TweetyDaBird/Lotus-58-BLE/v1.20/bom/README.md

# Interactive BOM
To view the interactive bom, use the html preview link here: http://htmlpreview.github.io/?https://github.com/TweetyDaBird/Lotus-58-BLE/blob/main/v1.20/bom/ibom.html
