TweetyDaBird/Lotus-58-BLE/Schematic.pdf

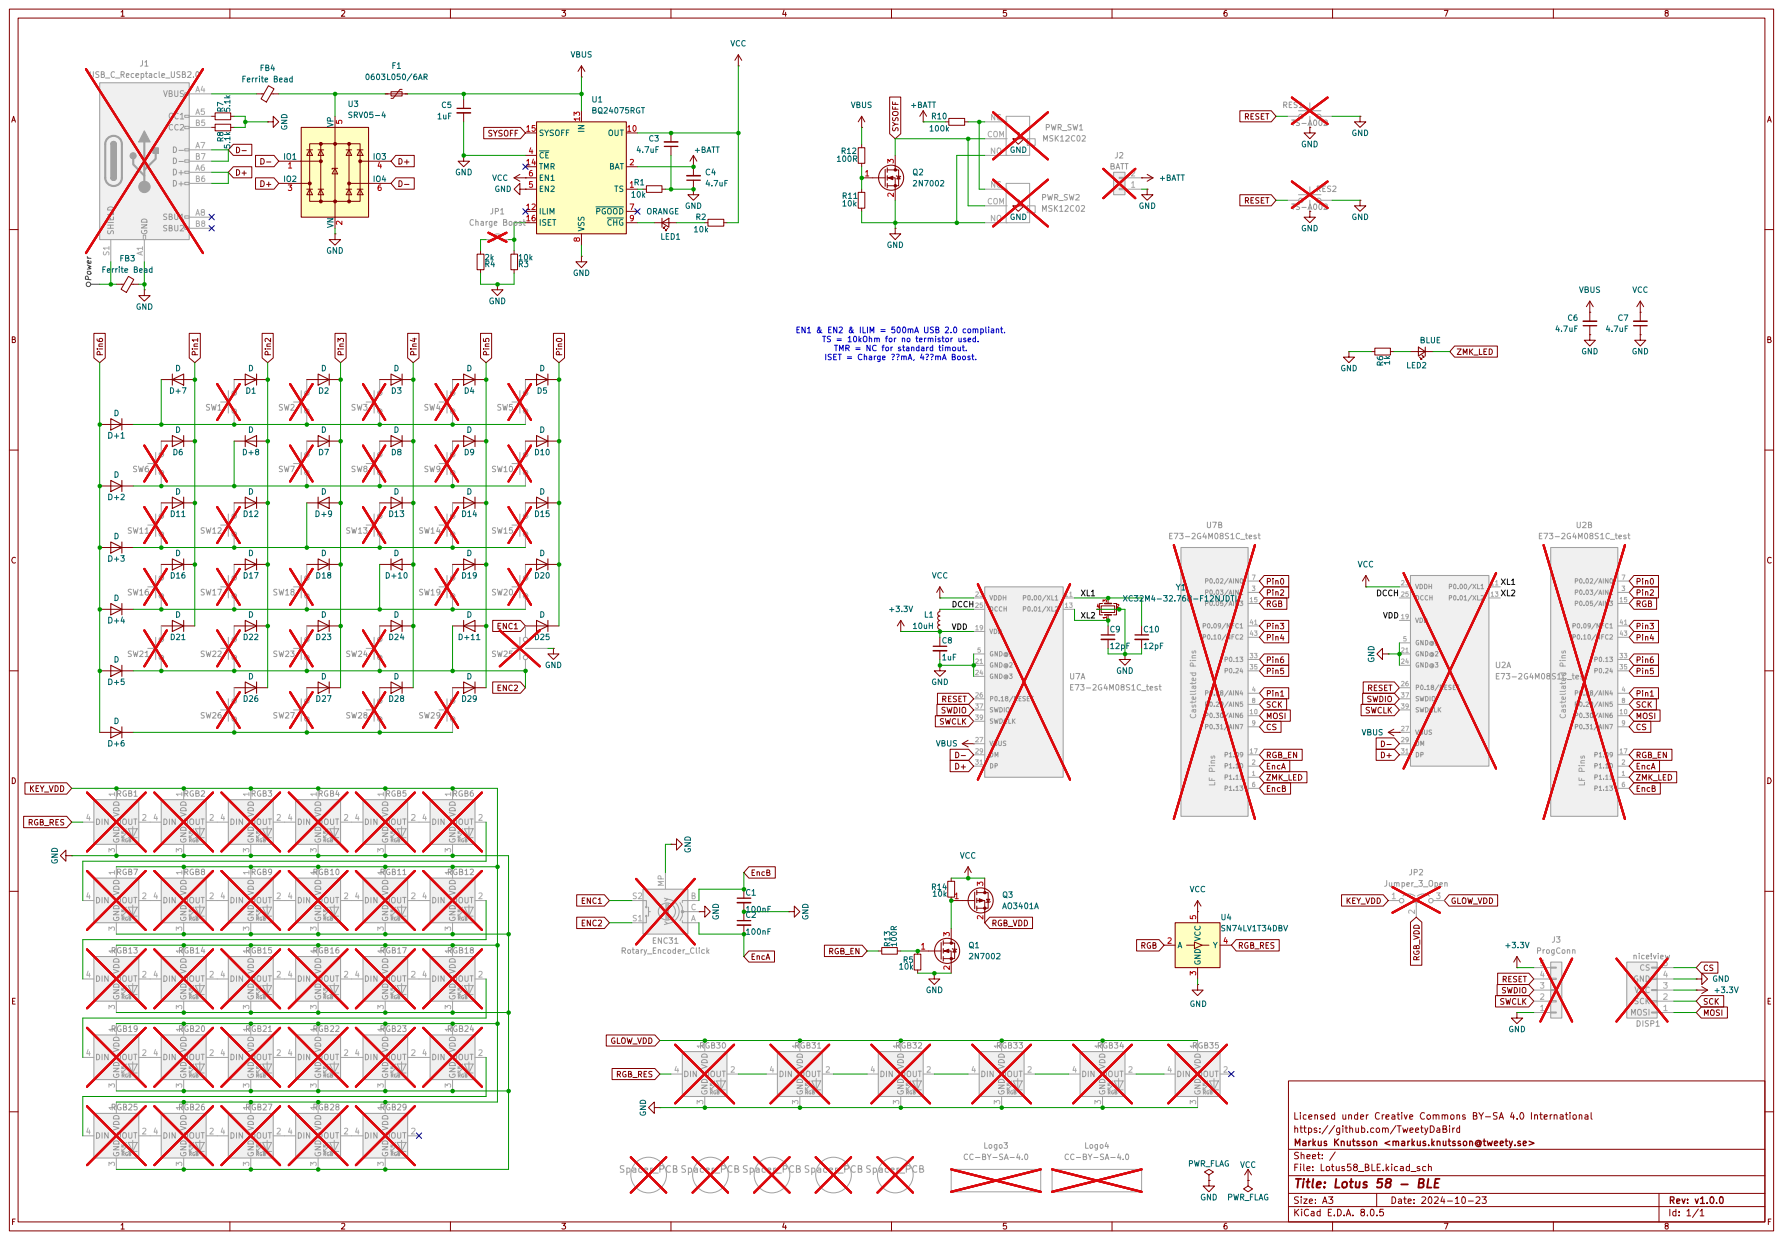
[picture p1: page 1]
