TweetyDaBird/Lotus-58-BLE/v1.20/Lotus58_BLE.kicad_pcb

## KiCad design v1.20/Lotus58_BLE.kicad_pcb (2025-06-25)

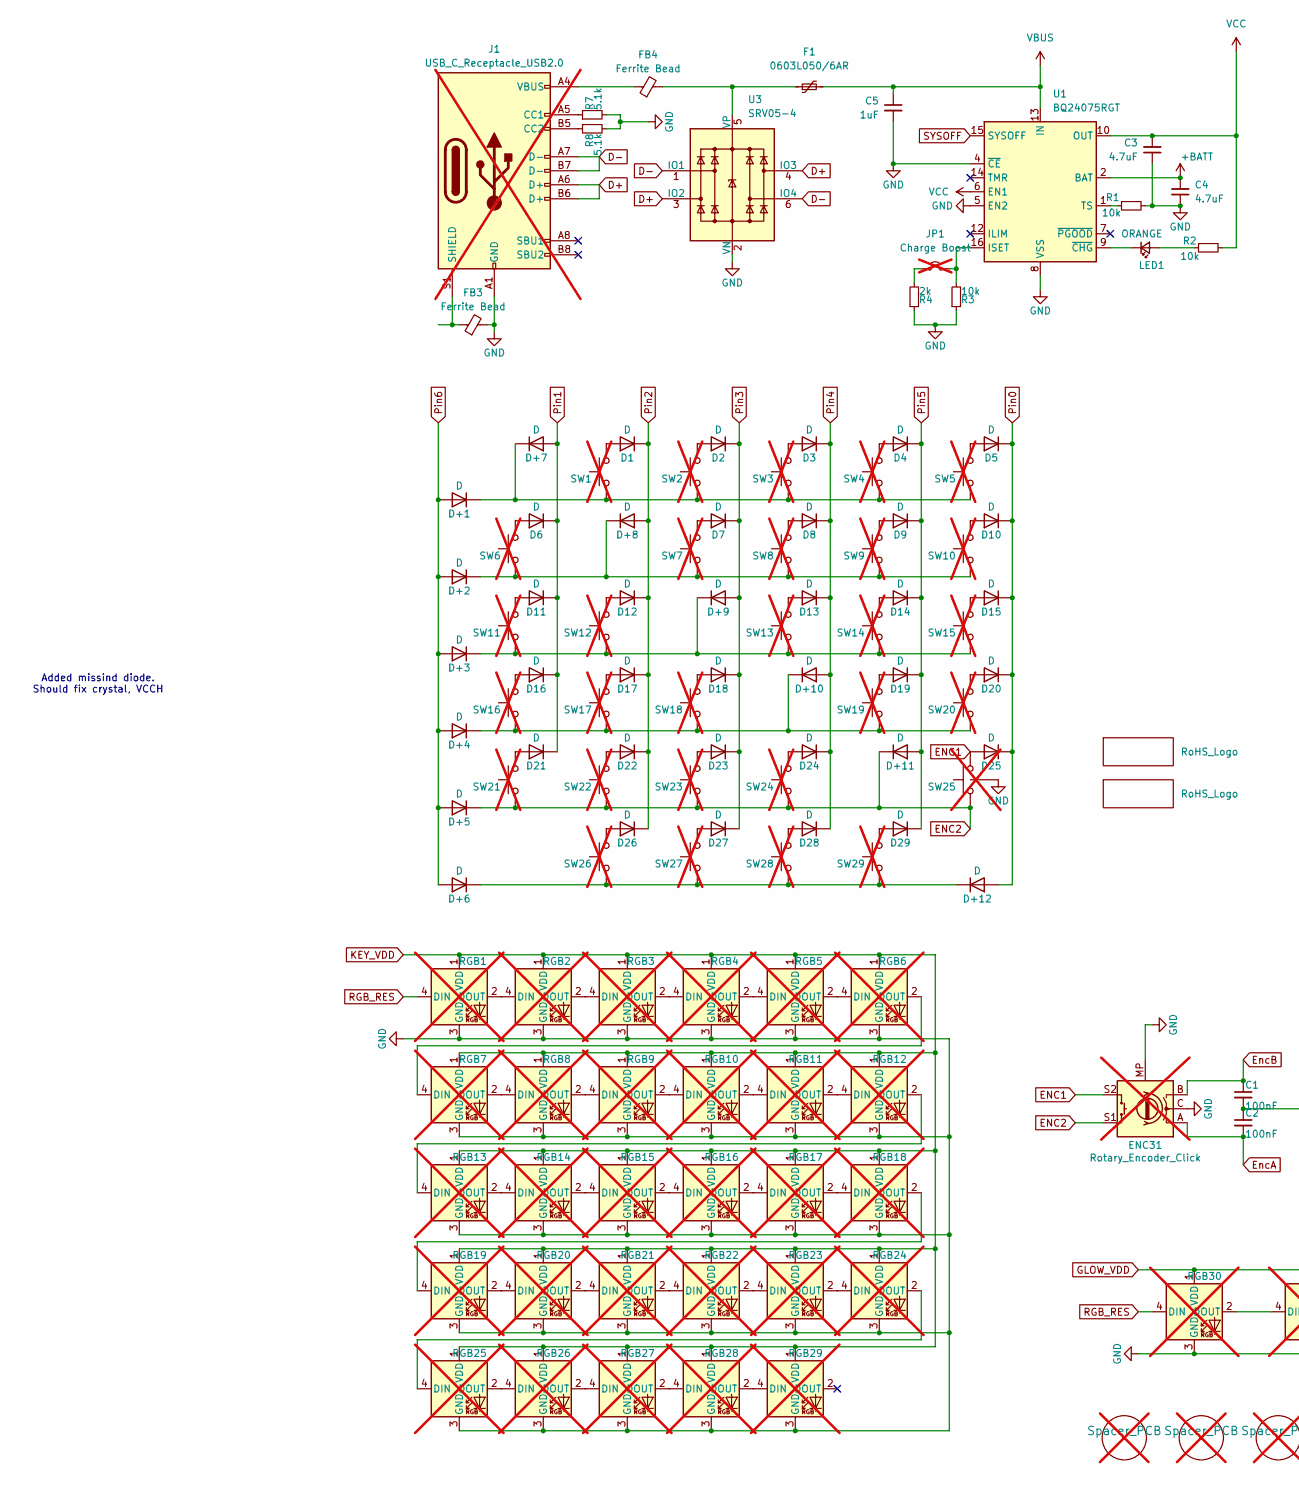
[picture p2: schematic Lotus58_BLE.kicad_sch, Lotus 58 - BLE, part in row 1, column 1]

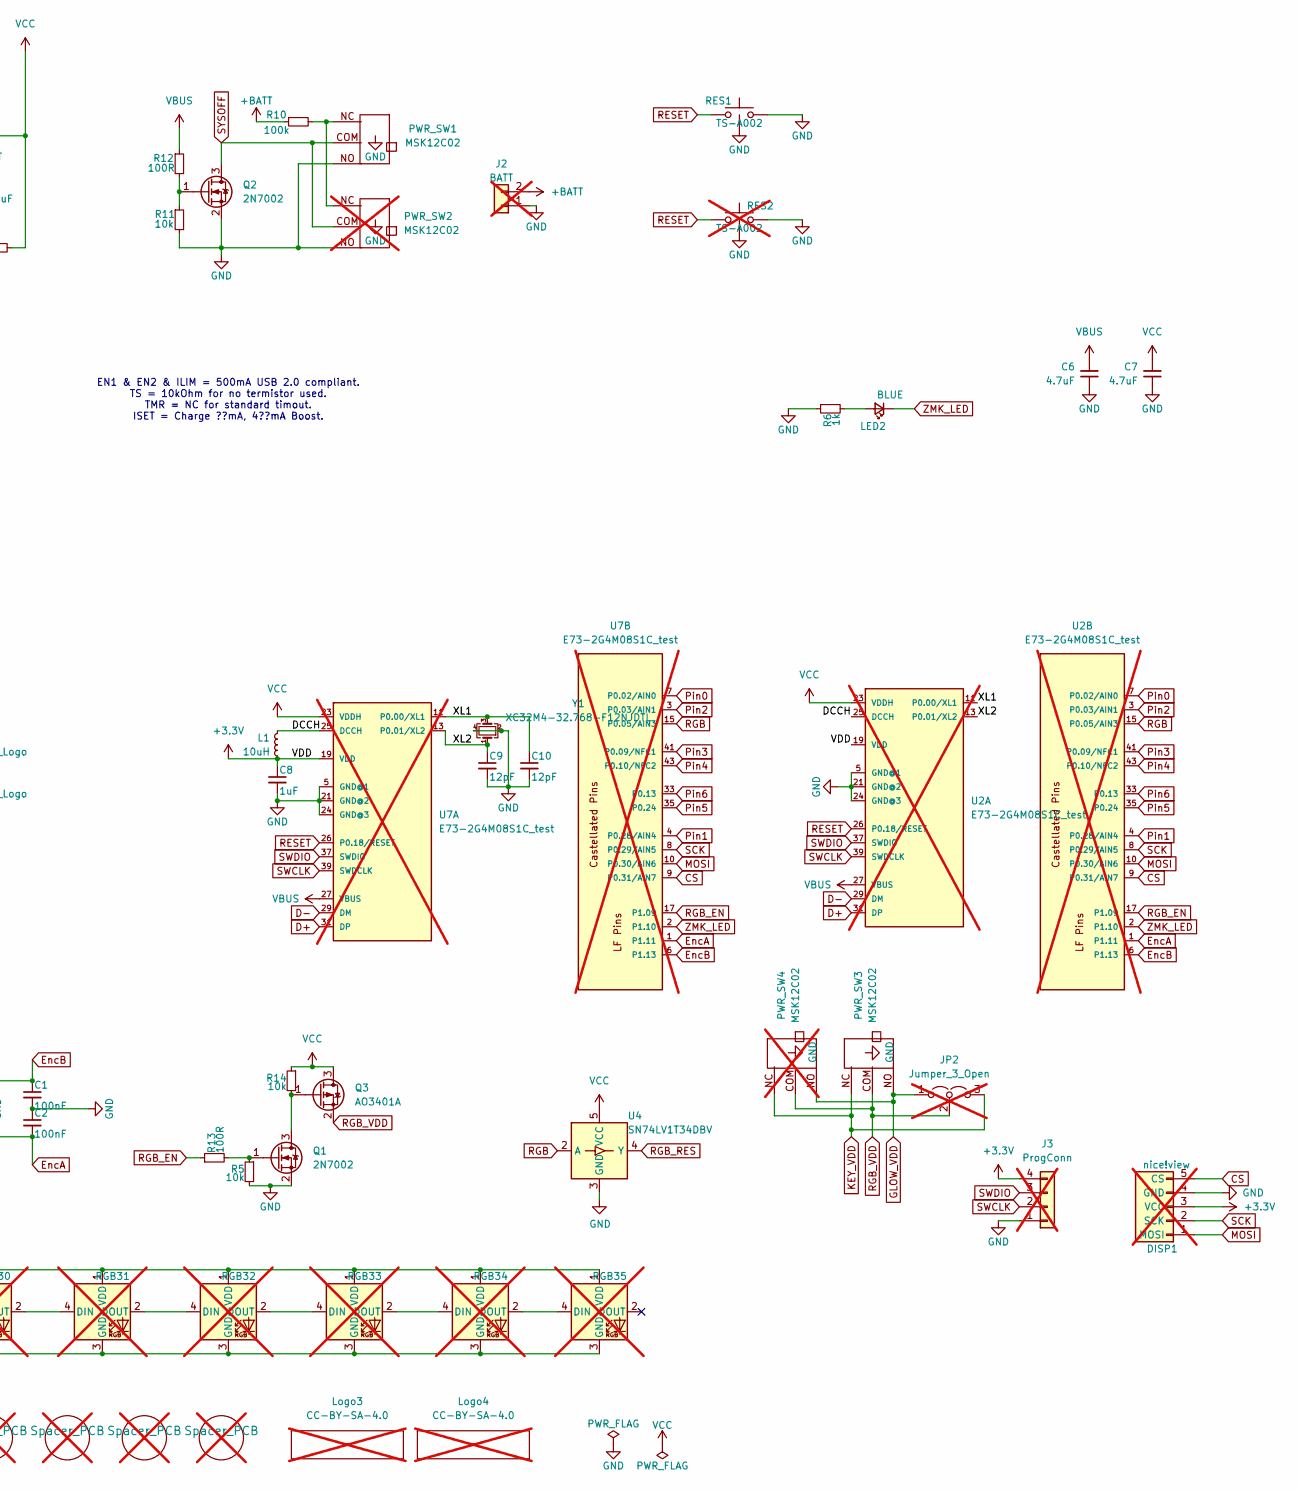
[picture p3: schematic Lotus58_BLE.kicad_sch, Lotus 58 - BLE, part in row 1, column 2]

Parts:
C1, C2: 100nF; C_0402_1005Metric; LCSC C1525
C3, C4, C6, C7: 4.7uF; C_0402_1005Metric; LCSC C274416
C5, C8: 1uF; C_0402_1005Metric; LCSC C52923
C9, C10: 12pF; C_0402_1005Metric; LCSC C424835
D1, D2, D3, D4, D5, D6, D7, D8, D9, D10, D11, D12, D13, D14, D15, D16, D17, D18, D19, D20, D21, D22, D23, D24, D25, D26, D27, D28, D29: D; D_SOD-323; LCSC C2128
D+1, D+2, D+3, D+4, D+5, D+6, D+7, D+8, D+9, D+10, D+11, D+12: D; D_SOD-323; LCSC C2128
DISP1: nice!view; nice!view_doublesided; not fitted
ENC31: Rotary_Encoder_Click; Encoder_Alps_EC11E_Small; not fitted
F1: 0603L050/6AR; R_0603_1608Metric; LCSC Part # C163116
FB3, FB4: Ferrite Bead; C_0603_1608Metric_Pad1.08x0.95mm_HandSolder; LCSC C1002
H1, H2, H3, H4, H5: Spacer_PCB; Spacer PCB hole; not fitted
J1: USB_C_Receptacle_USB2.0; HRO_TYPE-C-31-M-12_double_sided; LCSC C963373; not fitted
J2: BATT; PinHeader_1x02_P2.00mm_Vertical; not fitted
J3: ProgConn; PinHeader_1x04_P2.00mm_Vertical; not fitted
JP1: Charge Boost; Jumper_min_v2; not fitted
JP2: Jumper_3_Open; SolderJumper-3_open_mini; not fitted
L1: 10uH; L_0603_1608Metric; LCSC C180941
LED1: ORANGE; LED_0402_1005Metric; LCSC C965791
LED2: BLUE; LED_0402_1005Metric; LCSC C131223
Logo1, Logo2: RoHS_Logo; RoHs
Logo3, Logo4: CC-BY-SA-4.0; CC_BY_SA_40; not fitted
PWR_SW1, PWR_SW3: MSK12C02
PWR_SW2, PWR_SW4: MSK12C02; not fitted
Q1, Q2: 2N7002; SOT-23; LCSC C916396
Q3: AO3401A; SOT-23; LCSC C15127
R1, R2, R3, R5, R11, R14: 10k; R_0402_1005Metric; LCSC C25744
R4: 2k; R_0402_1005Metric; LCSC C472865
R6: 1k; R_0402_1005Metric; LCSC C11702
R7, R8: 5.1k; R_0402_1005Metric; LCSC C25905
R10: 100k; R_0402_1005Metric; LCSC C2982964
R12, R13: 100R; R_0402_1005Metric; LCSC C226677
RES1: TS-A002; YTS-A002; LCSC C2888934
RES2: TS-A002; YTS-A002; LCSC C2888934; not fitted
RGB1, RGB2, RGB3, RGB4, RGB5, RGB6, RGB7, RGB8, RGB9, RGB10, RGB11, RGB12, RGB13, RGB14, RGB15, RGB16, RGB17, RGB18, RGB19, RGB20, RGB21, RGB22, RGB23, RGB24, RGB25, RGB26, RGB27, RGB28, RGB29: SK6812MINI-E; RGB_SK6812MINI-E_reversible_tight; not fitted
RGB30, RGB31, RGB32, RGB33, RGB34, RGB35: SK6812MINI-E; MX_SK6812MINI-E_REVERSIBLE_special_v2; not fitted
SW1, SW2, SW3, SW4, SW5, SW6, SW7, SW8, SW9, SW10, SW11, SW12, SW13, SW14, SW15, SW16, SW17, SW18, SW19, SW20, SW21, SW22, SW23, SW24, SW26, SW27, SW28, SW29: SW_Push; SW_MX_HotSwap_Reversible; not fitted
SW25: SW_Push; SW_MX_HotSwap_Reversible_FOR encoder; not fitted
U1: BQ24075RGT; VQFN-16-1EP_3x3mm_P0.5mm_EP1.6x1.6mm_ThermalVias; LCSC C15464
U2, U7: E73-2G4M08S1C_test; E73-2G4M08S1C_Castellated; not fitted
U3: SRV05-4; SOT-23-6; LCSC C558418
U4: SN74LV1T34DBV; SOT-23-5; LCSC Part # C100024
Y1: XC32M4-32.768-F12NJDTL; Crystal_SMD_3225-4Pin_3.2x2.5mm; LCSC C5119018

Connections:
+3.3V: C8.1, DISP1.3 (VCC), J3.4, L1.2, U2.19 (VDD), U7.19 (VDD)
+BATT: C4.2, J2.2, R10.1, U1.2 (BAT), U1.3 (BAT)
/DCCH: L1.1, U2.25 (DCCH), U7.25 (DCCH)
/XL1: C10.1, U2.11 (P0.00/XL1), U7.11 (P0.00/XL1), Y1.3
/XL2: C9.1, U2.13 (P0.01/XL2), U7.13 (P0.01/XL2), Y1.1
CS: DISP1.5 (CS), U2.9 (P0.31/AIN7), U7.9 (P0.31/AIN7)
D+: J1.A6 (D+), J1.B6 (D+), U2.31 (DP), U3.3 (IO2), U3.4 (IO3), U7.31 (DP)
D-: J1.A7 (D-), J1.B7 (D-), U2.29 (DM), U3.1 (IO1), U3.6 (IO4), U7.29 (DM)
ENC1: D25.2 (A), ENC31.S2, SW25.1
ENC2: D+5.1 (K), D+11.1 (K), ENC31.S1, SW21.2, SW22.2, SW23.2, SW24.2, SW25.2
EncA: C2.2, ENC31.A, U2.1 (P1.11), U7.1 (P1.11)
EncB: C1.1, ENC31.B, U2.6 (P1.13), U7.6 (P1.13)
GLOW_VDD: JP2.1 (A), PWR_SW3.NO, PWR_SW4.NO, RGB30.1 (VDD), RGB31.1 (VDD), RGB32.1 (VDD), RGB33.1 (VDD), RGB34.1 (VDD), RGB35.1 (VDD)
GND: C1.2, C2.1, C3.1, C4.1, C5.2, C6.1, C7.1, C8.2, C9.2, C10.2, DISP1.4 (GND), ENC31.C, ENC31.MP (GND), FB3.2, J1.A1 (GND), J1.A12 (GND), J1.B1 (GND), J1.B12 (GND), J2.1, J3.1, PWR_SW1.MP (GND), PWR_SW1.NO, PWR_SW2.MP (GND), PWR_SW2.NO, PWR_SW3.MP (GND), PWR_SW4.MP (GND), Q1.2 (S), Q2.2 (S), R1.2, R3.1, R4.1, R5.2, R6.1, R7.2, R8.2, R11.2, RES1.1, RES1.3, RES2.2, RES2.3, RGB1.3 (GND), RGB2.3 (GND), RGB3.3 (GND), RGB4.3 (GND), RGB5.3 (GND), RGB6.3 (GND), RGB7.3 (GND), RGB8.3 (GND), RGB9.3 (GND), RGB10.3 (GND), RGB11.3 (GND), RGB12.3 (GND), RGB13.3 (GND), RGB14.3 (GND), RGB15.3 (GND), RGB16.3 (GND), RGB17.3 (GND), RGB18.3 (GND), RGB19.3 (GND), RGB20.3 (GND), RGB21.3 (GND), RGB22.3 (GND), RGB23.3 (GND), RGB24.3 (GND), RGB25.3 (GND), RGB26.3 (GND), RGB27.3 (GND), RGB28.3 (GND), RGB29.3 (GND), RGB30.3 (GND), RGB31.3 (GND), RGB32.3 (GND), RGB33.3 (GND), RGB34.3 (GND), RGB35.3 (GND), SW25.3, U1.4 (~CE), U1.5 (EN2), U1.8 (VSS), U1.17 (VSS), U2.5 (GND@1), U2.21 (GND@2), U2.24 (GND@3), U3.2 (VN), U4.3 (GND), U7.5 (GND@1), U7.21 (GND@2), U7.24 (GND@3), Y1.2, Y1.4
KEY_VDD: JP2.3 (B), PWR_SW3.NC, PWR_SW4.NC, RGB1.1 (VDD), RGB2.1 (VDD), RGB3.1 (VDD), RGB4.1 (VDD), RGB5.1 (VDD), RGB6.1 (VDD), RGB7.1 (VDD), RGB8.1 (VDD), RGB9.1 (VDD), RGB10.1 (VDD), RGB11.1 (VDD), RGB12.1 (VDD), RGB13.1 (VDD), RGB14.1 (VDD), RGB15.1 (VDD), RGB16.1 (VDD), RGB17.1 (VDD), RGB18.1 (VDD), RGB19.1 (VDD), RGB20.1 (VDD), RGB21.1 (VDD), RGB22.1 (VDD), RGB23.1 (VDD), RGB24.1 (VDD), RGB25.1 (VDD), RGB26.1 (VDD), RGB27.1 (VDD), RGB28.1 (VDD), RGB29.1 (VDD)
MOSI: DISP1.1 (MOSI), U2.10 (P0.30/AIN6), U7.10 (P0.30/AIN6)
unnamed: D1.2 (A), SW1.1
unnamed: D2.2 (A), SW2.1
unnamed: D3.2 (A), SW3.1
unnamed: D4.2 (A), SW4.1
unnamed: D5.2 (A), SW5.1
unnamed: D6.2 (A), SW6.1
unnamed: D7.2 (A), SW7.1
unnamed: D8.2 (A), SW8.1
unnamed: D9.2 (A), SW9.1
unnamed: D10.2 (A), SW10.1
unnamed: D11.2 (A), SW11.1
unnamed: D12.2 (A), SW12.1
unnamed: D13.2 (A), SW13.1
unnamed: D14.2 (A), SW14.1
unnamed: D15.2 (A), SW15.1
unnamed: D16.2 (A), SW16.1
unnamed: D17.2 (A), SW17.1
unnamed: D18.2 (A), SW18.1
unnamed: D19.2 (A), SW19.1
unnamed: D20.2 (A), SW20.1
unnamed: D21.2 (A), SW21.1
unnamed: D22.2 (A), SW22.1
unnamed: D23.2 (A), SW23.1
unnamed: D24.2 (A), SW24.1
unnamed: D26.2 (A), SW26.1
unnamed: D27.2 (A), SW27.1
unnamed: D28.2 (A), SW28.1
unnamed: D29.2 (A), SW29.1
unnamed: D+1.1 (K), D+7.1 (K), SW1.2, SW2.2, SW3.2, SW4.2, SW5.2
unnamed: D+2.1 (K), D+8.1 (K), SW6.2, SW7.2, SW8.2, SW9.2, SW10.2
unnamed: D+3.1 (K), D+9.1 (K), SW11.2, SW12.2, SW13.2, SW14.2, SW15.2
unnamed: D+4.1 (K), D+10.1 (K), SW16.2, SW17.2, SW18.2, SW19.2, SW20.2
unnamed: D+6.1 (K), D+12.1 (K), SW26.2, SW27.2, SW28.2, SW29.2
unnamed: FB4.1, J1.A4 (VBUS), J1.A9 (VBUS), J1.B4 (VBUS), J1.B9 (VBUS)
unnamed: J1.A5 (CC1), R7.1
unnamed: J1.B5 (CC2), R8.1
unnamed: FB3.1, J1.S1 (SHIELD)
unnamed: JP1.1 (A), R4.2
unnamed: JP1.2 (B), R3.2, U1.16 (ISET)
unnamed: LED1.2 (A), R2.1
unnamed: LED1.1 (K), U1.9 (~CHG)
unnamed: LED2.2 (A), R6.2
unnamed: PWR_SW1.NC, PWR_SW2.NC, R10.2
unnamed: Q1.3 (D), Q3.1 (G), R14.2
unnamed: Q1.1 (G), R5.1, R13.2
unnamed: Q2.1 (G), R11.1, R12.2
unnamed: RGB1.2 (DOUT), RGB2.4 (DIN)
unnamed: RGB2.2 (DOUT), RGB3.4 (DIN)
unnamed: RGB3.2 (DOUT), RGB4.4 (DIN)
unnamed: RGB4.2 (DOUT), RGB5.4 (DIN)
unnamed: RGB5.2 (DOUT), RGB6.4 (DIN)
unnamed: RGB6.2 (DOUT), RGB7.4 (DIN)
unnamed: RGB7.2 (DOUT), RGB8.4 (DIN)
unnamed: RGB8.2 (DOUT), RGB9.4 (DIN)
unnamed: RGB9.2 (DOUT), RGB10.4 (DIN)
unnamed: RGB10.2 (DOUT), RGB11.4 (DIN)
unnamed: RGB11.2 (DOUT), RGB12.4 (DIN)
unnamed: RGB12.2 (DOUT), RGB13.4 (DIN)
unnamed: RGB13.2 (DOUT), RGB14.4 (DIN)
unnamed: RGB14.2 (DOUT), RGB15.4 (DIN)
unnamed: RGB15.2 (DOUT), RGB16.4 (DIN)
unnamed: RGB16.2 (DOUT), RGB17.4 (DIN)
unnamed: RGB17.2 (DOUT), RGB18.4 (DIN)
unnamed: RGB18.2 (DOUT), RGB19.4 (DIN)
unnamed: RGB19.2 (DOUT), RGB20.4 (DIN)
unnamed: RGB20.2 (DOUT), RGB21.4 (DIN)
unnamed: RGB21.2 (DOUT), RGB22.4 (DIN)
unnamed: RGB22.2 (DOUT), RGB23.4 (DIN)
unnamed: RGB23.2 (DOUT), RGB24.4 (DIN)
unnamed: RGB24.2 (DOUT), RGB25.4 (DIN)
unnamed: RGB25.2 (DOUT), RGB26.4 (DIN)
unnamed: RGB26.2 (DOUT), RGB27.4 (DIN)
unnamed: RGB27.2 (DOUT), RGB28.4 (DIN)
unnamed: RGB28.2 (DOUT), RGB29.4 (DIN)
unnamed: RGB30.2 (DOUT), RGB31.4 (DIN)
unnamed: RGB31.2 (DOUT), RGB32.4 (DIN)
unnamed: RGB32.2 (DOUT), RGB33.4 (DIN)
unnamed: RGB33.2 (DOUT), RGB34.4 (DIN)
unnamed: RGB34.2 (DOUT), RGB35.4 (DIN)
unnamed: R1.1, U1.1 (TS)
unnamed: F1.1, FB4.2, U3.5 (VP)
Pin0: D5.1 (K), D10.1 (K), D15.1 (K), D20.1 (K), D25.1 (K), D+12.2 (A), U2.7 (P0.02/AIN0), U7.7 (P0.02/AIN0)
Pin1: D6.1 (K), D11.1 (K), D16.1 (K), D21.1 (K), D+7.2 (A), U2.4 (P0.28/AIN4), U7.4 (P0.28/AIN4)
Pin2: D1.1 (K), D12.1 (K), D17.1 (K), D22.1 (K), D26.1 (K), D+8.2 (A), U2.3 (P0.03/AIN1), U7.3 (P0.03/AIN1)
Pin3: D2.1 (K), D7.1 (K), D18.1 (K), D23.1 (K), D27.1 (K), D+9.2 (A), U2.41 (P0.09/NFC1), U7.41 (P0.09/NFC1)
Pin4: D3.1 (K), D8.1 (K), D13.1 (K), D24.1 (K), D28.1 (K), D+10.2 (A), U2.43 (P0.10/NFC2), U7.43 (P0.10/NFC2)
Pin5: D4.1 (K), D9.1 (K), D14.1 (K), D19.1 (K), D29.1 (K), D+11.2 (A), U2.35 (P0.24), U7.35 (P0.24)
Pin6: D+1.2 (A), D+2.2 (A), D+3.2 (A), D+4.2 (A), D+5.2 (A), D+6.2 (A), U2.33 (P0.13), U7.33 (P0.13)
RESET: RES1.2, RES2.1, U2.26 (P0.18/RESET), U7.26 (P0.18/RESET)
RGB: U2.15 (P0.05/AIN3), U4.2 (A), U7.15 (P0.05/AIN3)
RGB_EN: R13.1, U2.17 (P1.09), U7.17 (P1.09)
RGB_RES: RGB1.4 (DIN), RGB30.4 (DIN), U4.4 (Y)
RGB_VDD: JP2.2 (C), PWR_SW3.COM, PWR_SW4.COM, Q3.2 (S)
SCK: DISP1.2 (SCK), U2.8 (P0.29/AIN5), U7.8 (P0.29/AIN5)
SWCLK: J3.2, U2.39 (SWDCLK), U7.39 (SWDCLK)
SWDIO: J3.3, U2.37 (SWDIO), U7.37 (SWDIO)
SYSOFF: PWR_SW1.COM, PWR_SW2.COM, Q2.3 (D), U1.15 (SYSOFF)
VBUS: C5.1, C6.2, F1.2, R12.1, U1.13 (IN), U2.27 (VBUS), U7.27 (VBUS)
VCC: C3.2, C7.2, Q3.3 (D), R2.2, R14.1, U1.6 (EN1), U1.10 (OUT), U1.11 (OUT), U2.23 (VDDH), U4.5 (VCC), U7.23 (VDDH)
ZMK_LED: LED2.1 (K), U2.2 (P1.10), U7.2 (P1.10)

Notes on the sheet:
EN1 & EN2 & ILIM = 500mA USB 2.0 compliant. TS = 10kOhm for no termistor used. TMR = NC for standard timout. ISET = Charge ??mA, 4??mA Boost.
Added missind diode. Should fix crystal, VCCH

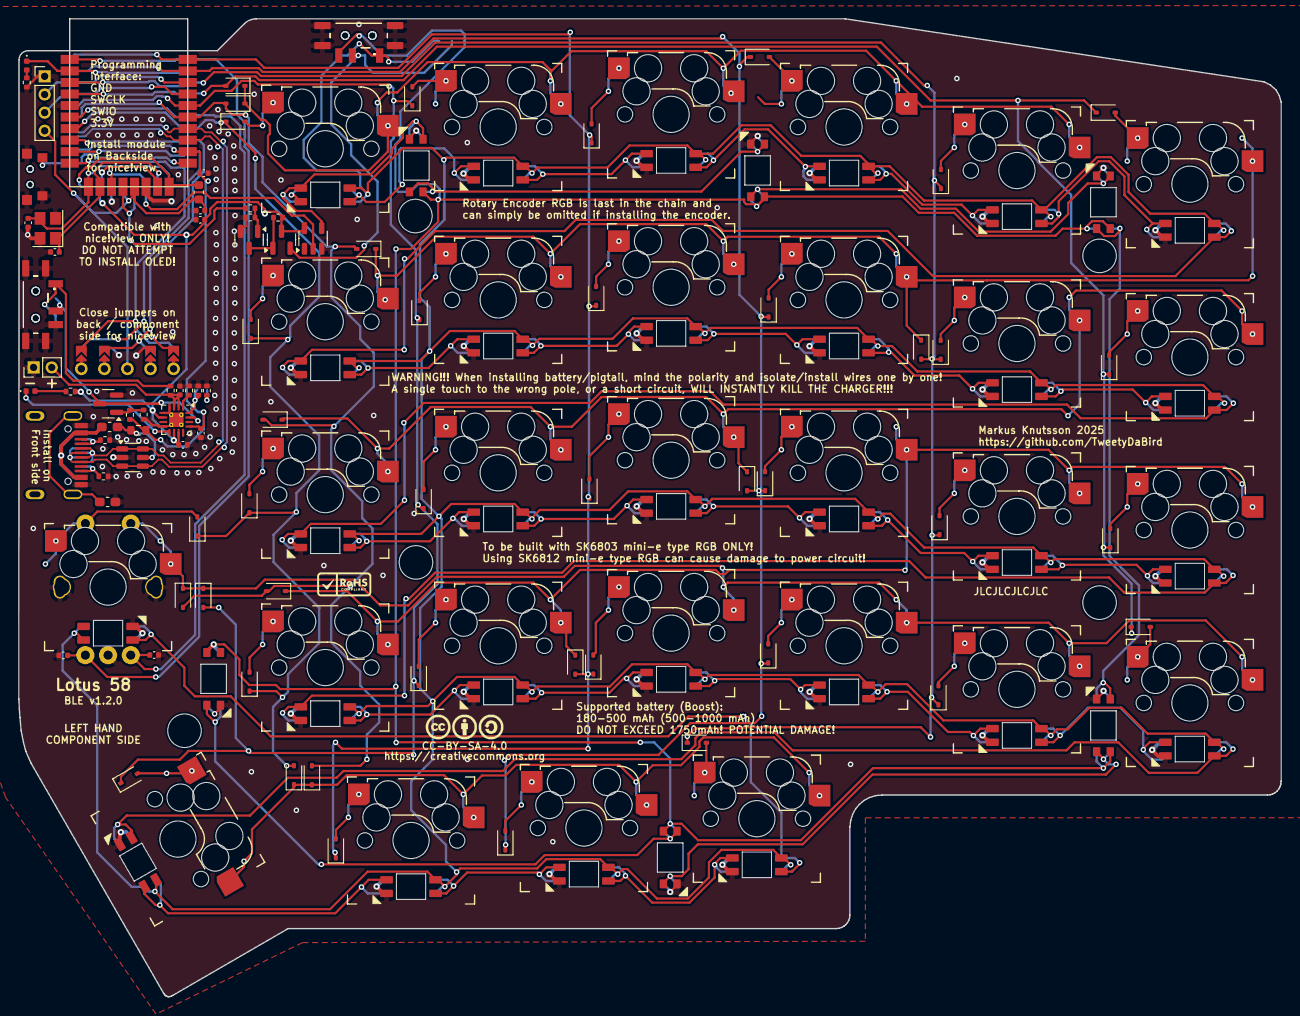
[picture p4: board Lotus58_BLE.kicad_pcb from above]

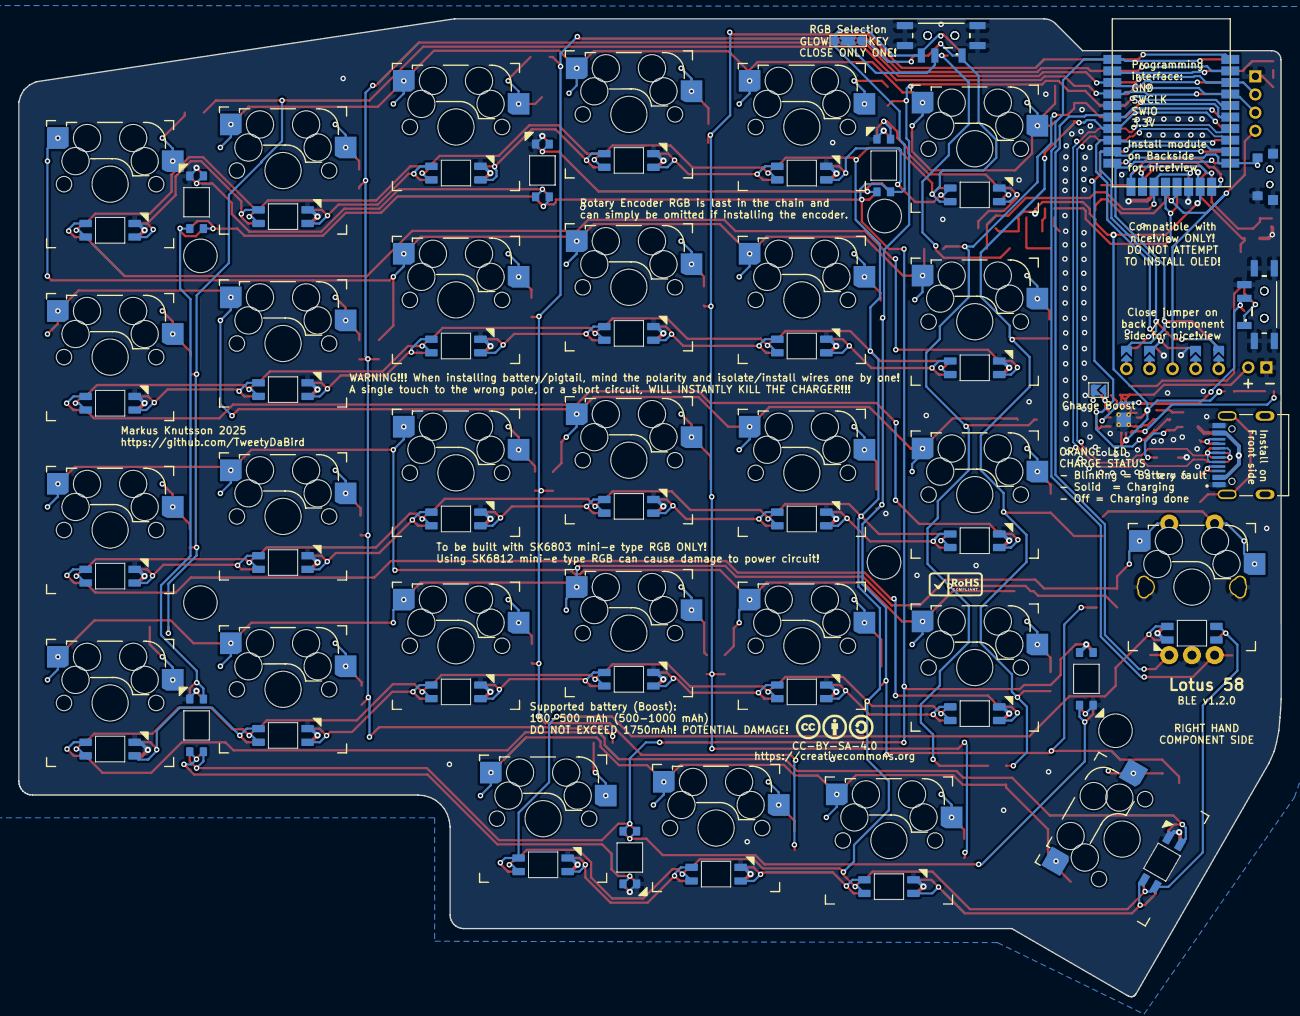
[picture p5: board Lotus58_BLE.kicad_pcb from below]

Board: 2 copper layers, 139.1 x 107.7 mm, 165 parts (9 on the bottom side), 116 nets.
