TweetyDaBird/Lotus-58-BLE/(commit log)

2024-11-15 Initial Design
    [Lotus58_BLE.kicad_pcb, Lotus58_BLE.kicad_sch]
2024-11-15 Add Schematic as PDF
2025-06-25 V1.2.0
    Added RGB selector
    [Lotus58_BLE.kicad_pcb, Lotus58_BLE.kicad_sch]
2026-11-10 Add README for interactive BOM
