TweetyDaBird/Lotus-58-BLE/(notices)

Notices in the files:
v1.10/Lotus58_BLE.kicad_pcb:
Licensed under Creative Commons BY-SA 4.0 International
